Smart-Eraser/Final-Project-Report/README.md

# Final-Project-Report
This is the repository that contains the code for the final version of the Final Project report for the Smart Eraser. All code used in the project is in the Appendices folder as well.
