Smart-Eraser/Final-Project-Report/Appendices/ultrasonic.py

from machine import Pin
import utime
import np_lights as f1
while True:
  trig=Pin(12,Pin.OUT)
  trig.off()
  utime.sleep_us(2)
  trig.on()
  utime.sleep_us(10)
  trig.off()
  echo=Pin(13,Pin.IN)
  while echo.value() == 0:
    pass
  t1 = utime.ticks_us()
  while echo.value() == 1:
    pass
  t2 = utime.ticks_us()
  M = (t2-t1)/148.0
  utime.sleep_us(250)

  print(M)
  if M < 30:
    f1.lights(1)
  elif M > 30:
    f1.lights(0)
  utime.sleep_us(250)
