Smart-Eraser/Final-Project-Report/Appendices/Arducam.c

/*****************************************************************************
* File Name: 	 Arducam.c
*
* Version: 		1.0
*
* Description:	This file holds all the function definitions for the Arducam
*
* Author:		Chris Quesada
*******************************************************************************/

#include <Arducam.h>
#include <SPImaster.h>
#include <I2CMaster.h>
#include <interface.h>
#include <ImProc.h>
#include <math.h>

struct sensor_reg
{
   uint16_t reg;
   uint8 val;
};

struct sensor_reg OV5642_1280x960_RAW[RAWinit] =
{
{0x00ff,0x01},
{0x3008,0x80},
{0x3103,0x93},
{0x3008,0x02},
{0x3017,0x7f},
{0x3018,0xf0},
{0x3615,0xf0},
{0x3000,0xF8},
{0x3001,0x48},
{0x3002,0x5c},
{0x3003,0x02},
{0x3005,0xB7},
{0x3006,0x43},
{0x3007,0x37},
{0x300f,0x06},
{0x3011,0x08},
{0x3010,0x20},
{0x3012,0x00},
{0x460c,0x22},
{0x3815,0x04},
{0x370c,0xA0},
{0x3602,0xFC},
{0x3612,0xFF},
{0x3634,0xC0},
{0x3613,0x00},
{0x3622,0x00},
{0x3603,0x27},
{0x4000,0x21},
{0x401D,0x02},
{0x3600,0x54},
{0x3605,0x04},
{0x3606,0x3F},
{0x5020,0x04},
{0x5197,0x01},
{0x5001,0xFF},
{0x5500,0x10},
{0x5502,0x00},
{0x5503,0x04},
{0x5504,0x00},
{0x5505,0x7F},
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

{0xffff,0xff},
};

struct sensor_reg OV5642_320x240_RAW[RAWres] =
{
	/*
{0x3800,0x03},
{0x3801,0xE8},
{0x3802,0x03},
{0x3803,0xE8},
{0x3804,0x38},
{0x3805,0x00},
{0x3806,0x03},
{0x3807,0xC0},
*/
{0x3808,0x01},
{0x3809,0x40},
{0x380A,0x00},
{0x380B,0xf0},
{0xffff,0xff},
};



/******************************************************************************
* Function Name: MyCam_Test
*******************************************************************************
*
* Summary: 		Tests SPI communication between PSoC 6 and Arducam
*
* Parameters: 	uint16_t *rxBuffer,
* 				uint16_t *txBuffer
*
* Return:		Value in test register of Arducam (rxBuffer[0])
*
******************************************************************************/
void MyCam_Test(uint16_t rxBuffer, uint16_t txBuffer) {

	uint16_t response = 0;

	do {
	txBuffer = (((uint16_t)WRITE + (uint16_t)TEST_SPI) << 8) + (uint16_t)TEST_VALUE;
	Write_SPI(txBuffer);
	txBuffer = (((uint16_t)READ + (uint16_t)TEST_SPI) << 8) + (uint16_t)DUMMY;
	response = Write_SPI(txBuffer);
	} while ( response != TEST_VALUE);
}

/******************************************************************************
* Function Name: MyCam_Trigger
*******************************************************************************
*
* Summary: 		Clears FIFO Flag and Sends trigger signal to have camera
* 				capture image.
*
* Parameters: 	uint16_t *rxBuffer,
* 				uint16_t *txBuffer
*
* Return:		none
*
******************************************************************************/
void MyCam_Trigger(uint16_t rxBuffer, uint16_t txBuffer) {

	txBuffer = (((uint16_t)WRITE + (uint16_t)FIFO_CONTROL) << 8) + (uint16_t)CLEAR_FIFO_FLAG;
	Write_SPI(txBuffer);
	Cy_SysLib_Delay(0.5);

	txBuffer = (((uint16_t)WRITE + (uint16_t)FIFO_CONTROL) << 8) + (uint16_t)CLEAR_FIFO_FLAG;
	Write_SPI(txBuffer);
	Cy_SysLib_Delay(0.5);

	txBuffer = (((uint16_t)WRITE + (uint16_t)FIFO_CONTROL) << 8) + (uint16_t)CAPTURE;
	Write_SPI(txBuffer);
	Cy_SysLib_Delay(0.5);
}

/******************************************************************************
* Function Name: MyCam_Check_Capture_Status
*******************************************************************************
*
* Summary: 		Check capture flag to see if capture is complete
*
* Parameters: 	uint16_t *rxBuffer,
* 				uint16_t *txBuffer
*
* Return:		none
*
******************************************************************************/
uint16_t MyCam_Check_Capture_Status(uint16_t rxBuffer, uint16_t txBuffer) {

	uint16_t response = 0;

	txBuffer = (((uint16_t)READ + (uint16_t)CAPTURE_FLAG) << 8) + (uint16_t)DUMMY;
	response = Write_SPI(txBuffer);

	return response;
}
/******************************************************************************
* Function Name: MyCam_Single_FIFO_Read
*******************************************************************************
*
* Summary: 		Reads 2 bytes of data from cam and them attempts to demosaic
* 				the raw data, still in development
*
* Parameters: 	uint16_t *rxBuffer,
* 				uint16_t *txBuffer
*
* Return:		none
*
******************************************************************************/
unsigned short* MyCam_Pixel_Read(uint16_t txBuffer, uint16_t *ptr_PD, int position, uint8 *BayerFilter) {

		uint16_t Red = 0;
		uint16_t Green1 = 0;
		uint16_t Green2 = 0;
		uint16_t Blue = 0;
		uint8 *start = BayerFilter;
		int j = 0;
		int k = 0;


		if (position == 0) {
			for (int j = 0; j < 1; j++) {
				for (int k = 0; k < Length; k++) {
				txBuffer = (((uint16_t)READ + (uint16_t)FIFO_READ_SINGLE) << 8) + (uint16_t)DUMMY;
				*BayerFilter = Write_SPI(txBuffer);
				BayerFilter = BayerFilter + 1;
				}
			}
			for (int k = 0; k < Length - 1; k++) {
				if (k % 2 == 0) {
					Blue 	= *BayerFilter >> 3;
					Green1 	= (*BayerFilter + 1) >> 2 << 5;
					Green2 	= (*BayerFilter + Length) >> 2 << 5;
					Red 	= (*BayerFilter + Length + 1) >> 3 << 11;
					*ptr_PD = Blue + ((Green1 + Green2) / 2) + Red;
					ptr_PD = ptr_PD + 1;
					BayerFilter = BayerFilter + 1;
					}
				else if (k % 2 != 0) {
					Green1 	= *BayerFilter >> 2 << 5;
					Blue 	= (*BayerFilter + 1) >> 3;
					Red 	= (*BayerFilter + Length) >> 3 << 11;
					Green2 	= (*BayerFilter + Length + 1) >> 2 << 5;
					*ptr_PD = Blue + ((Green1 + Green2) / 2) + Red;
					ptr_PD = ptr_PD + 1;
					BayerFilter = BayerFilter + 1;
					}
				}
		ptr_PD = ptr_PD + 1;
		BayerFilter = BayerFilter + 1;
		Green1 	= *BayerFilter >> 2 << 5;
		Blue 	= (*BayerFilter - 1) >> 3;
		Red 	= (*BayerFilter - Length) >> 3 << 11;
		Green2 	= (*BayerFilter - Length - 1) >> 2 << 5;
		*ptr_PD = Blue + ((Green1 + Green2) / 2) + Red;
		}

		else if (position == 1) {

			for (k = 0; k < Length; k++) {
				*BayerFilter = *BayerFilter + Length;
				BayerFilter = BayerFilter + 1;
			}

			for (int k = 0; k < Length; k++) {
				txBuffer = (((uint16_t)READ + (uint16_t)FIFO_READ_SINGLE) << 8) + (uint16_t)DUMMY;
				*BayerFilter = Write_SPI(txBuffer);
				BayerFilter = BayerFilter + 1;
			}

			BayerFilter = start;

			for (int k = 0; k < Length - 1; k++) {
				if (k % 2 == 0) {
					Blue 	= *BayerFilter >> 3;
					Green1 	= (*BayerFilter + 1) >> 2 << 5;
					Green2 	= (*BayerFilter + Length) >> 2 << 5;
					Red 	= (*BayerFilter + Length + 1) >> 3 << 11;
					*ptr_PD = Blue + ((Green1 + Green2) / 2) + Red;
					ptr_PD = ptr_PD + 1;
					BayerFilter = BayerFilter + 1;
					}
				else if (k % 2 != 0) {
					Green1 	= *BayerFilter >> 2 << 5;
					Blue 	= (*BayerFilter + 1) >> 3;
					Red 	= (*BayerFilter + Length) >> 3 << 11;
					Green2 	= (*BayerFilter + Length + 1) >> 2 << 5;
					*ptr_PD = Blue + ((Green1 + Green2) / 2) + Red;
					ptr_PD = ptr_PD + 1;
					BayerFilter = BayerFilter + 1;
					}
				}
		ptr_PD = ptr_PD + 1;
		BayerFilter = BayerFilter + 1;
		Green1 	= *BayerFilter >> 2 << 5;
		Blue 	= (*BayerFilter - 1) >> 3 << 11;
		Red 	= (*BayerFilter - Length) >> 3 << 11;
		Green2 	= (*BayerFilter - Length - 1) >> 2 << 5;
		*ptr_PD = Blue + ((Green1 + Green2) / 2) + Red;
		}

		else if (position == 2) {

			for (k = 0; k < Length; k++) {
				*BayerFilter = *BayerFilter + Length;
				BayerFilter = BayerFilter + 1;
			}

			for (int k = 0; k < Length; k++) {
				txBuffer = (((uint16_t)READ + (uint16_t)FIFO_READ_SINGLE) << 8) + (uint16_t)DUMMY;
				*BayerFilter = Write_SPI(txBuffer);
				BayerFilter = BayerFilter + 1;
			}

			BayerFilter = start;

			for (int k = 0; k < Length - 1; k++) {
				if (k % 2 == 0) {
					Green1 	= *BayerFilter >> 2 << 5;
					Red 	= (*BayerFilter + 1) >> 3 << 11;
					Blue 	= (*BayerFilter + Length)>> 3;
					Green2 	= (*BayerFilter + Length + 1)>> 2 << 5;
					*ptr_PD = Blue + ((Green1 + Green2) / 2) + Red;
					ptr_PD = ptr_PD + 1;
					BayerFilter = BayerFilter + 1;
					}
				else if (k % 2 != 0) {
					Red 	= *BayerFilter >> 3 << 11;
					Green1 	= (*BayerFilter + 1) >> 2 << 5;
					Green2 	= (*BayerFilter + Length) >> 2 << 5;
					Blue 	= (*BayerFilter + Length + 1) >> 3;
					*ptr_PD = Blue + ((Green1 + Green2) / 2) + Red;
					ptr_PD = ptr_PD + 1;
					BayerFilter = BayerFilter + 1;
					}
				}
		ptr_PD = ptr_PD + 1;
		BayerFilter = BayerFilter + 1;
		Red 	= *BayerFilter >> 3 << 11;
		Green1 	= (*BayerFilter - 1) >> 2 << 5;
		Green2 	= (*BayerFilter - Length) >> 2 << 5;
		Blue 	= (*BayerFilter - Length - 1) >> 3;
		*ptr_PD = Blue + ((Green1 + Green2) / 2) + Red;
		}
		return ptr_PD;
}

/******************************************************************************
* Function Name: MyCam_Single_Dummy_Read
*******************************************************************************
*
* Summary: 		Handles the first dummy byte of RGB565 data
*
* Parameters: 	uint16_t *rxBuffer,
* 				uint16_t *txBuffer
*
* Return:		none
*
******************************************************************************/
void MyCam_Single_DUMMY_Read(uint16_t txBuffer, uint16_t *ptr_PD) {
	 Write_SPI(txBuffer);
}

/******************************************************************************
* Function Name: MyCamInit
*******************************************************************************
*
* Summary: 		Initializes camera sensor to RGB565 320x240
*
* Parameters: 	None
*
* Return:		None
*
******************************************************************************/

void MyCam_Init(void) {

	int k 									= 0;
	uint8 buffer[NUMBER_OF_I2C_ELEMENTS] 	= {0};

	for (k = 0; k < RAWinit; k++) {
		buffer[0] =	OV5642_1280x960_RAW[k].reg >> 8;
		buffer[1] = OV5642_1280x960_RAW[k].reg;
		buffer[2] = OV5642_1280x960_RAW[k].val;
		Write_I2C(buffer, NUMBER_OF_I2C_ELEMENTS);
	}
	Cy_SysLib_Delay(1000);

	for (k = 0; k < RAWres; k++) {
		buffer[0] =	OV5642_320x240_RAW[k].reg >> 8;
		buffer[1] = OV5642_320x240_RAW[k].reg;
		buffer[2] = OV5642_320x240_RAW[k].val;
		Write_I2C(buffer, NUMBER_OF_I2C_ELEMENTS);
	}
	Cy_SysLib_Delay(250);
};

/******************************************************************************
* Function Name: handle_error
*******************************************************************************
*
* Summary: 		This is a blocking function. It disables the interrupt and waits
* 				in an infinite loop. This function is called when an error is
* 				encountered during initialization of the blocks or during
* 				SPI communication. This was provided by Cypress
*
* Parameters: 	None
*
* Return:		None
*
******************************************************************************/
void handle_error(void)
{
	 /* Disable all interrupts. */
	__disable_irq();

	/* Infinite loop. */
	while(1u) {}
}
